ITstreet1/WHITEBoard-DevKitC-S3/Schematic/Schematic_WHITEBoard S3 DevKitC_2022-04-27.pdf

IO0 27 IO35 28 IO36 29 IO37 30 IO38 31 IO39 32 IO40 33 IO41 34 IO42 35 RXD0 36 TXD0 37 IO2 38 IO1 39 GND 40 EPAD 41

# JP2 EXT_IO¹

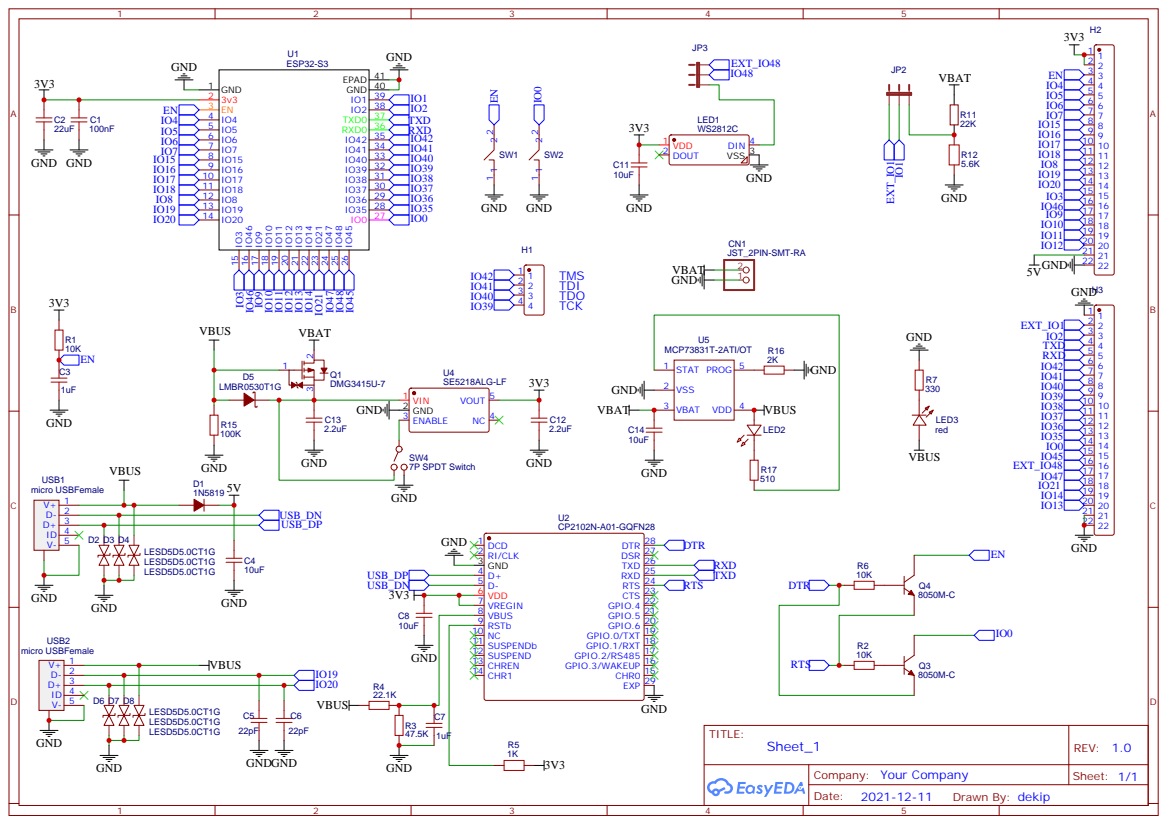
[picture p1: page 1]
