ITstreet1/WHITEBoard-DevKitC-S3/CircuitPython/secrets.py

# SPDX-FileCopyrightText: 2020 Adafruit Industries
#
# SPDX-License-Identifier: Unlicense

# This file is where you keep secret settings, passwords, and tokens!
# If you put them in the code you risk committing that info or sharing it

secrets = {
    'ssid' : 'ssid',
    'password' : 'password',
    'aio_username' : 'my_adafruit_io_username',
    'aio_key' : 'my_adafruit_io_key',
    'timezone' : "Serbia/Belgrade", # http://worldtimeapi.org/timezones
    }
